awjlogan/emon32/pcb/models/Amphenol12402012E212A.STEP

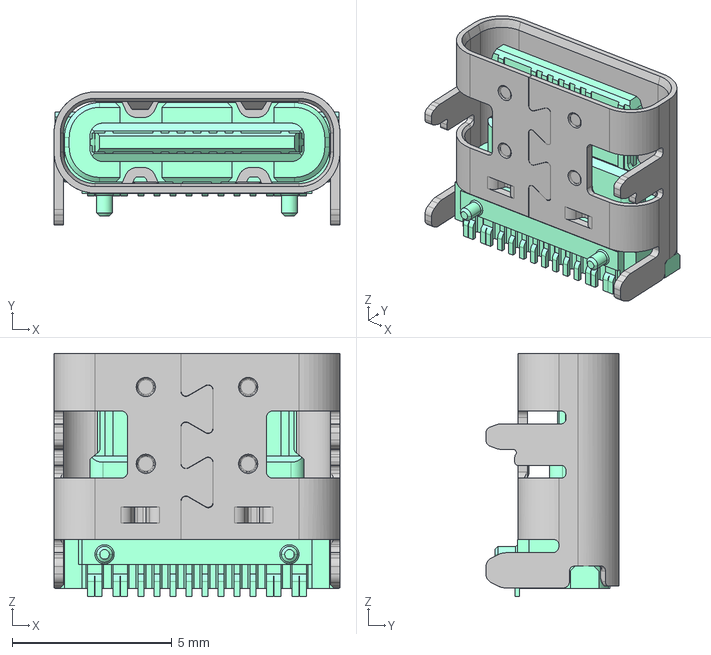
[picture p3: CAD file, 2025-05-18]
pcb/models/Amphenol12402012E212A.STEP
8.94 x 4.16 x 7.60 mm
