awjlogan/emon32/pcb/emonpi3/fascias/export-emonpi3-V1.0/back-emonpi3-V1.0.dxf

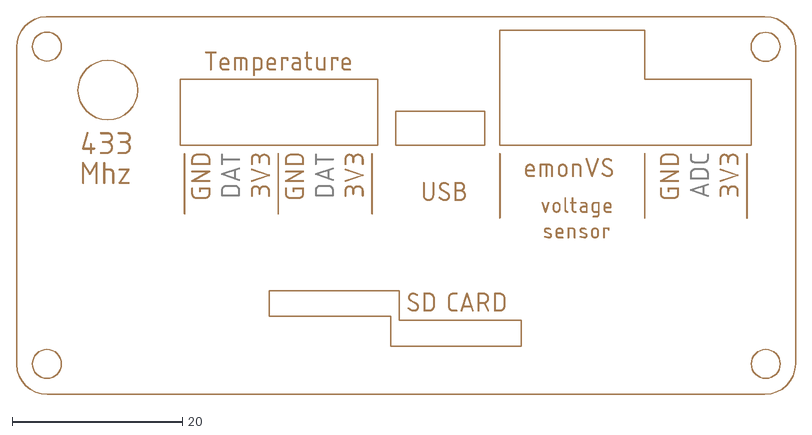
[picture p4: CAD file, 2025-11-04]
pcb/emonpi3/fascias/export-emonpi3-V1.0/back-emonpi3-V1.0.dxf
91.4 x 44.4
