awjlogan/emon32/pcb/models/pxc_5441388_01_00_BCH-350H-6-GN_3D.stp

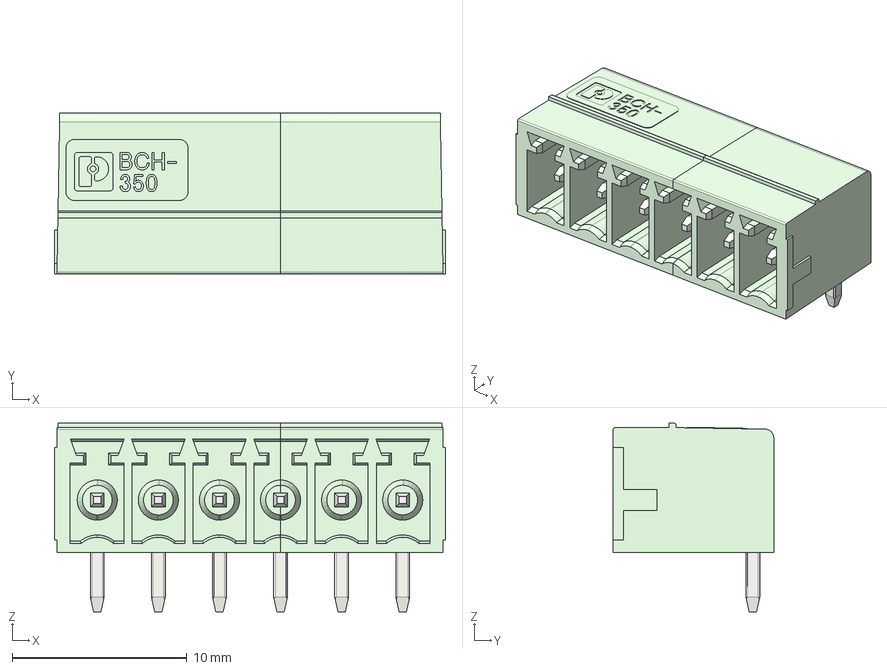
[picture p5: CAD file, 2025-05-18]
pcb/models/pxc_5441388_01_00_BCH-350H-6-GN_3D.stp
22.4 x 9.20 x 10.8 mm
