awjlogan/emon32/pcb/emonpi3/fascias/export-emonpi3-V1.0/top-emonpi3-V1.0.dxf

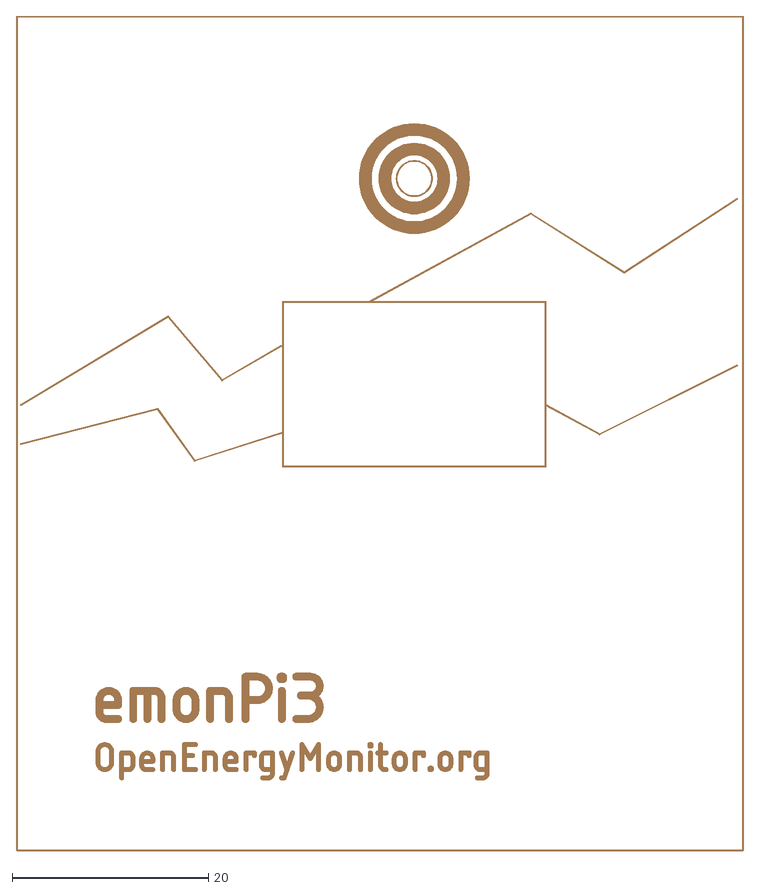
[picture p6: CAD file, 2025-11-04]
pcb/emonpi3/fascias/export-emonpi3-V1.0/top-emonpi3-V1.0.dxf
74.1 x 85.2
