awjlogan/emon32/pcb/models/pxc_5441359_01_00_BCH-350H-3-GN_3D.stp

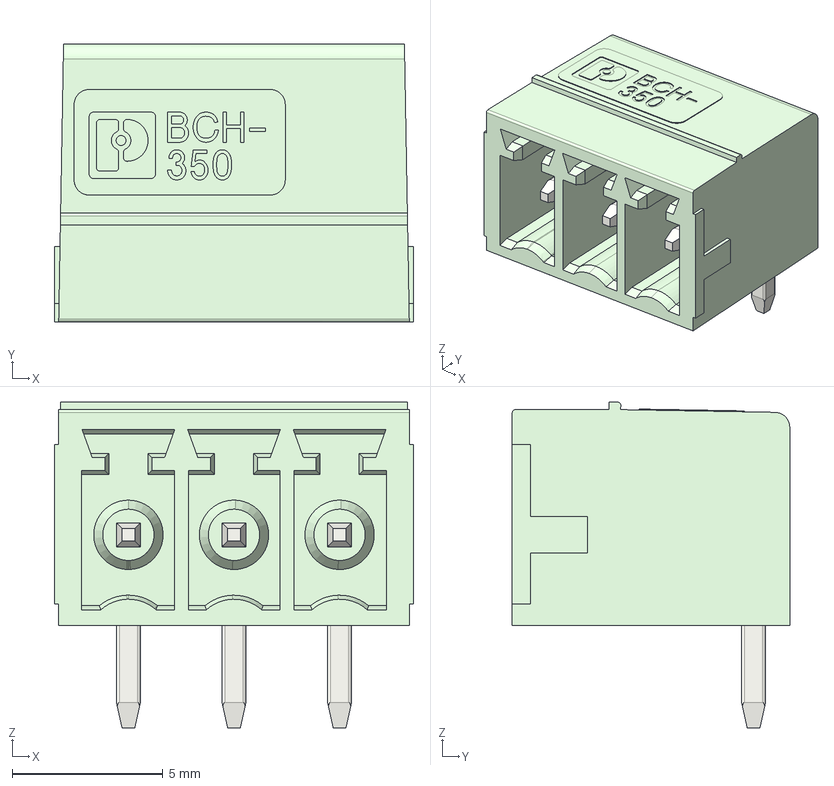
[picture p7: CAD file, 2025-05-18]
pcb/models/pxc_5441359_01_00_BCH-350H-3-GN_3D.stp
11.9 x 9.20 x 10.8 mm
