awjlogan/emon32/pcb/emonpi3/fascias/export-emonpi3-V1.0/frontA-emonpi3-V1.0.dxf

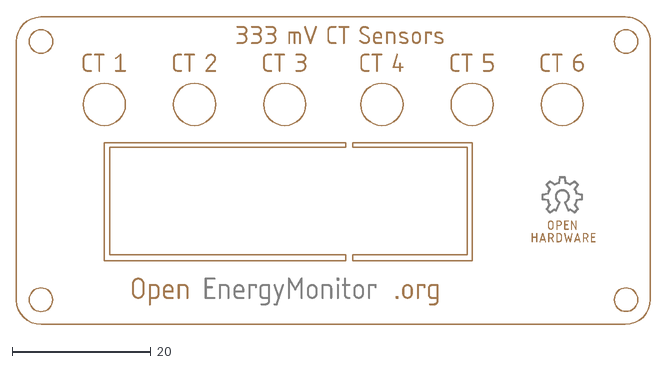
[picture p8: CAD file, 2025-11-04]
pcb/emonpi3/fascias/export-emonpi3-V1.0/frontA-emonpi3-V1.0.dxf
91.5 x 44.4
