awjlogan/emon32/pcb/models/TPS2116DRLR.stp

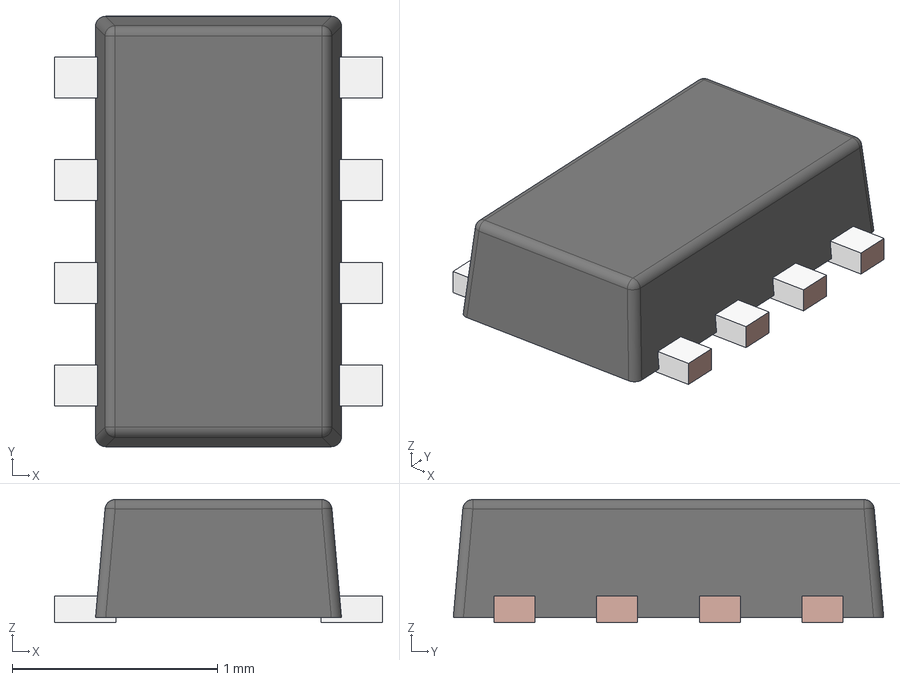
[picture p9: CAD file, 2024-09-29]
pcb/models/TPS2116DRLR.stp
1.60 x 2.10 x 0.6 mm
FRAME-DRL0008A
BODY-SOT
