awjlogan/emon32/pcb/models/LTST-S326KGJRKT.stp

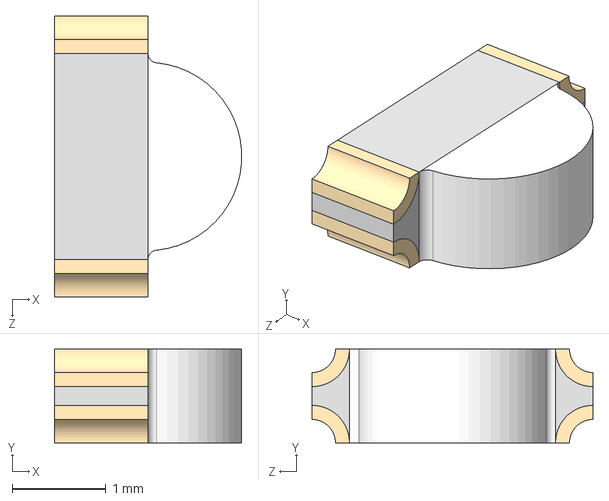
[picture p10: CAD file, 2024-09-29]
pcb/models/LTST-S326KGJRKT.stp
2.00 x 1.00 x 3.00 mm
