awjlogan/emon32/pcb/models/HLE-120-02-F-DV.stp

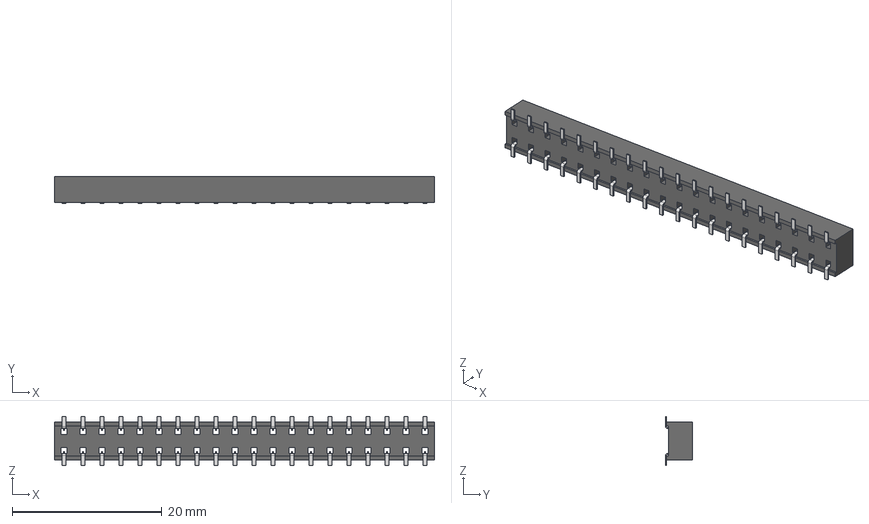
[picture p11: CAD file, 2024-09-29]
pcb/models/HLE-120-02-F-DV.stp
50.8 x 3.66 x 6.58 mm
HLE-120-02-DV_socket
C-132-12-20-F-DV
C-132-12-20-F-DV2
