awjlogan/emon32/pcb/models/CUI_DEVICES_SJ-3523-SMT-TR.step

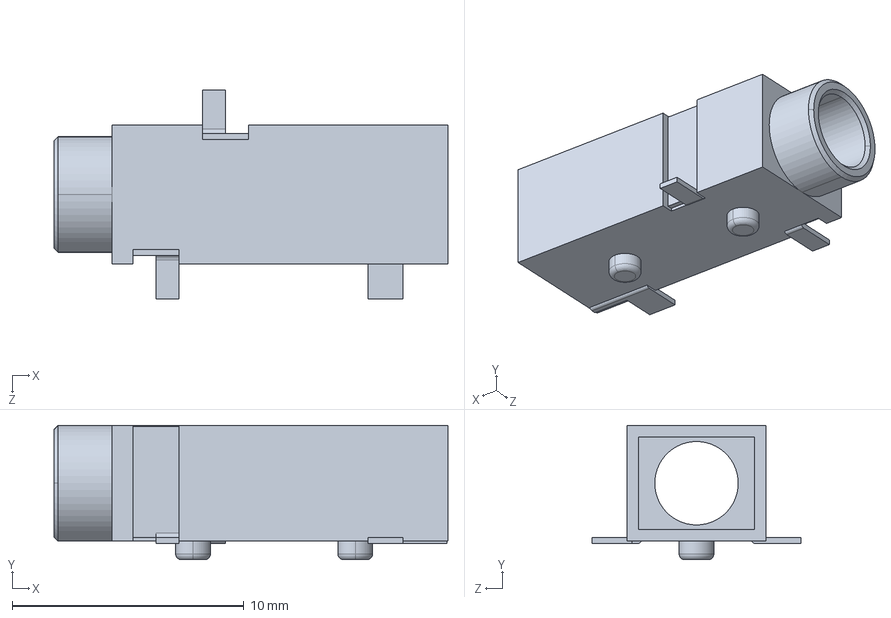
[picture p12: CAD file, 2023-05-02]
pcb/models/CUI_DEVICES_SJ-3523-SMT-TR.step
17.0 x 5.80 x 9.00 mm
