awjlogan/emon32/pcb/models/132136-12.stp

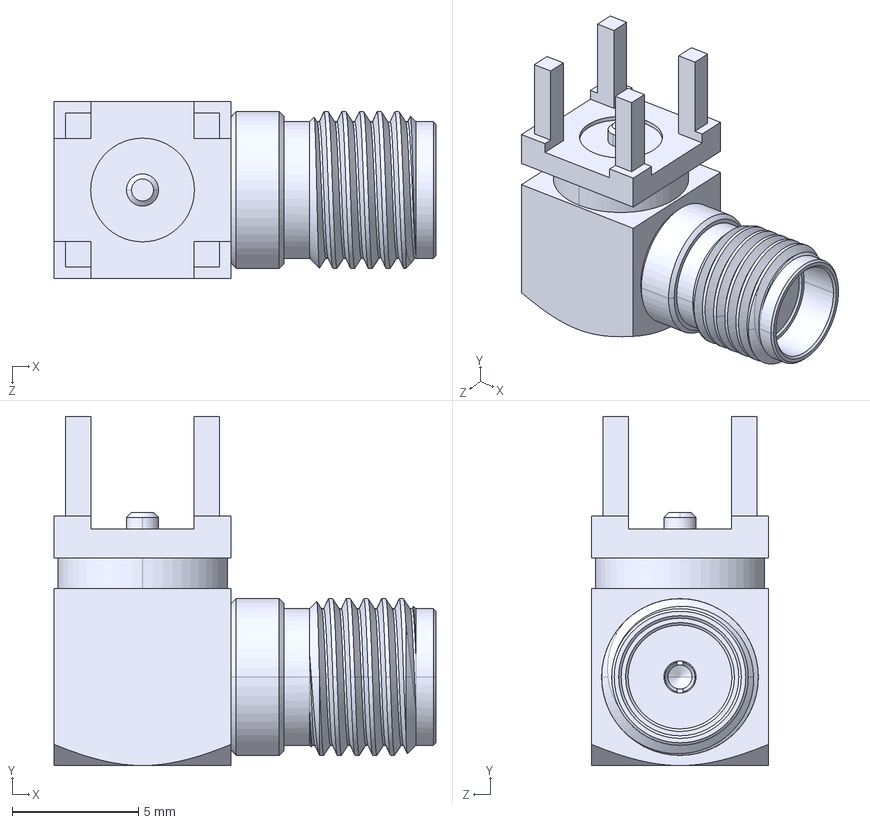
[picture p13: CAD file, 2024-03-06]
pcb/models/132136-12.stp
15.1 x 13.8 x 7.00 mm
