awjlogan/emon32/pcb/models/54601-906WPLFc.stp

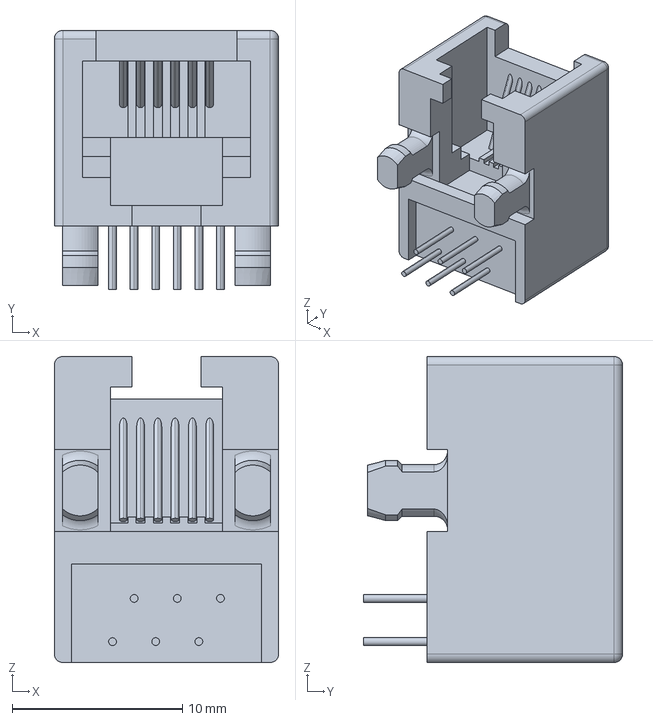
[picture p14: CAD file, 2023-05-02]
pcb/models/54601-906WPLFc.stp
13.2 x 15.2 x 18.0 mm
