awjlogan/emon32/pcb/models/54602-908LFc.stp

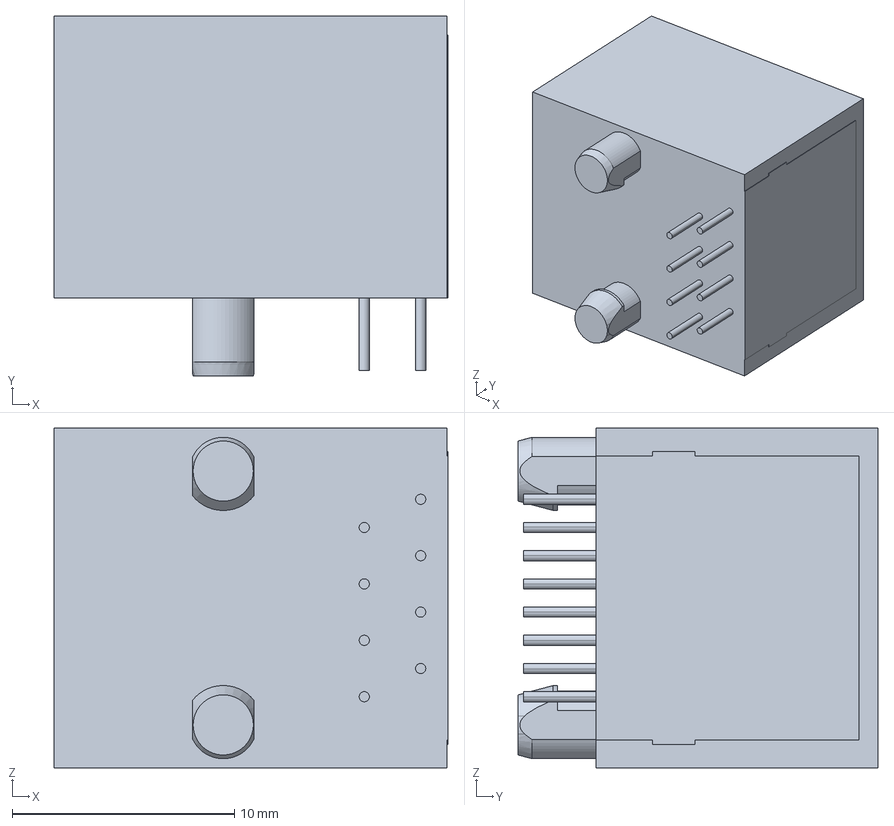
[picture p15: CAD file, 2023-05-02]
pcb/models/54602-908LFc.stp
17.7 x 16.2 x 15.3 mm
