awjlogan/emon32/pcb/emonpi3/emonPi3-schematic.pdf

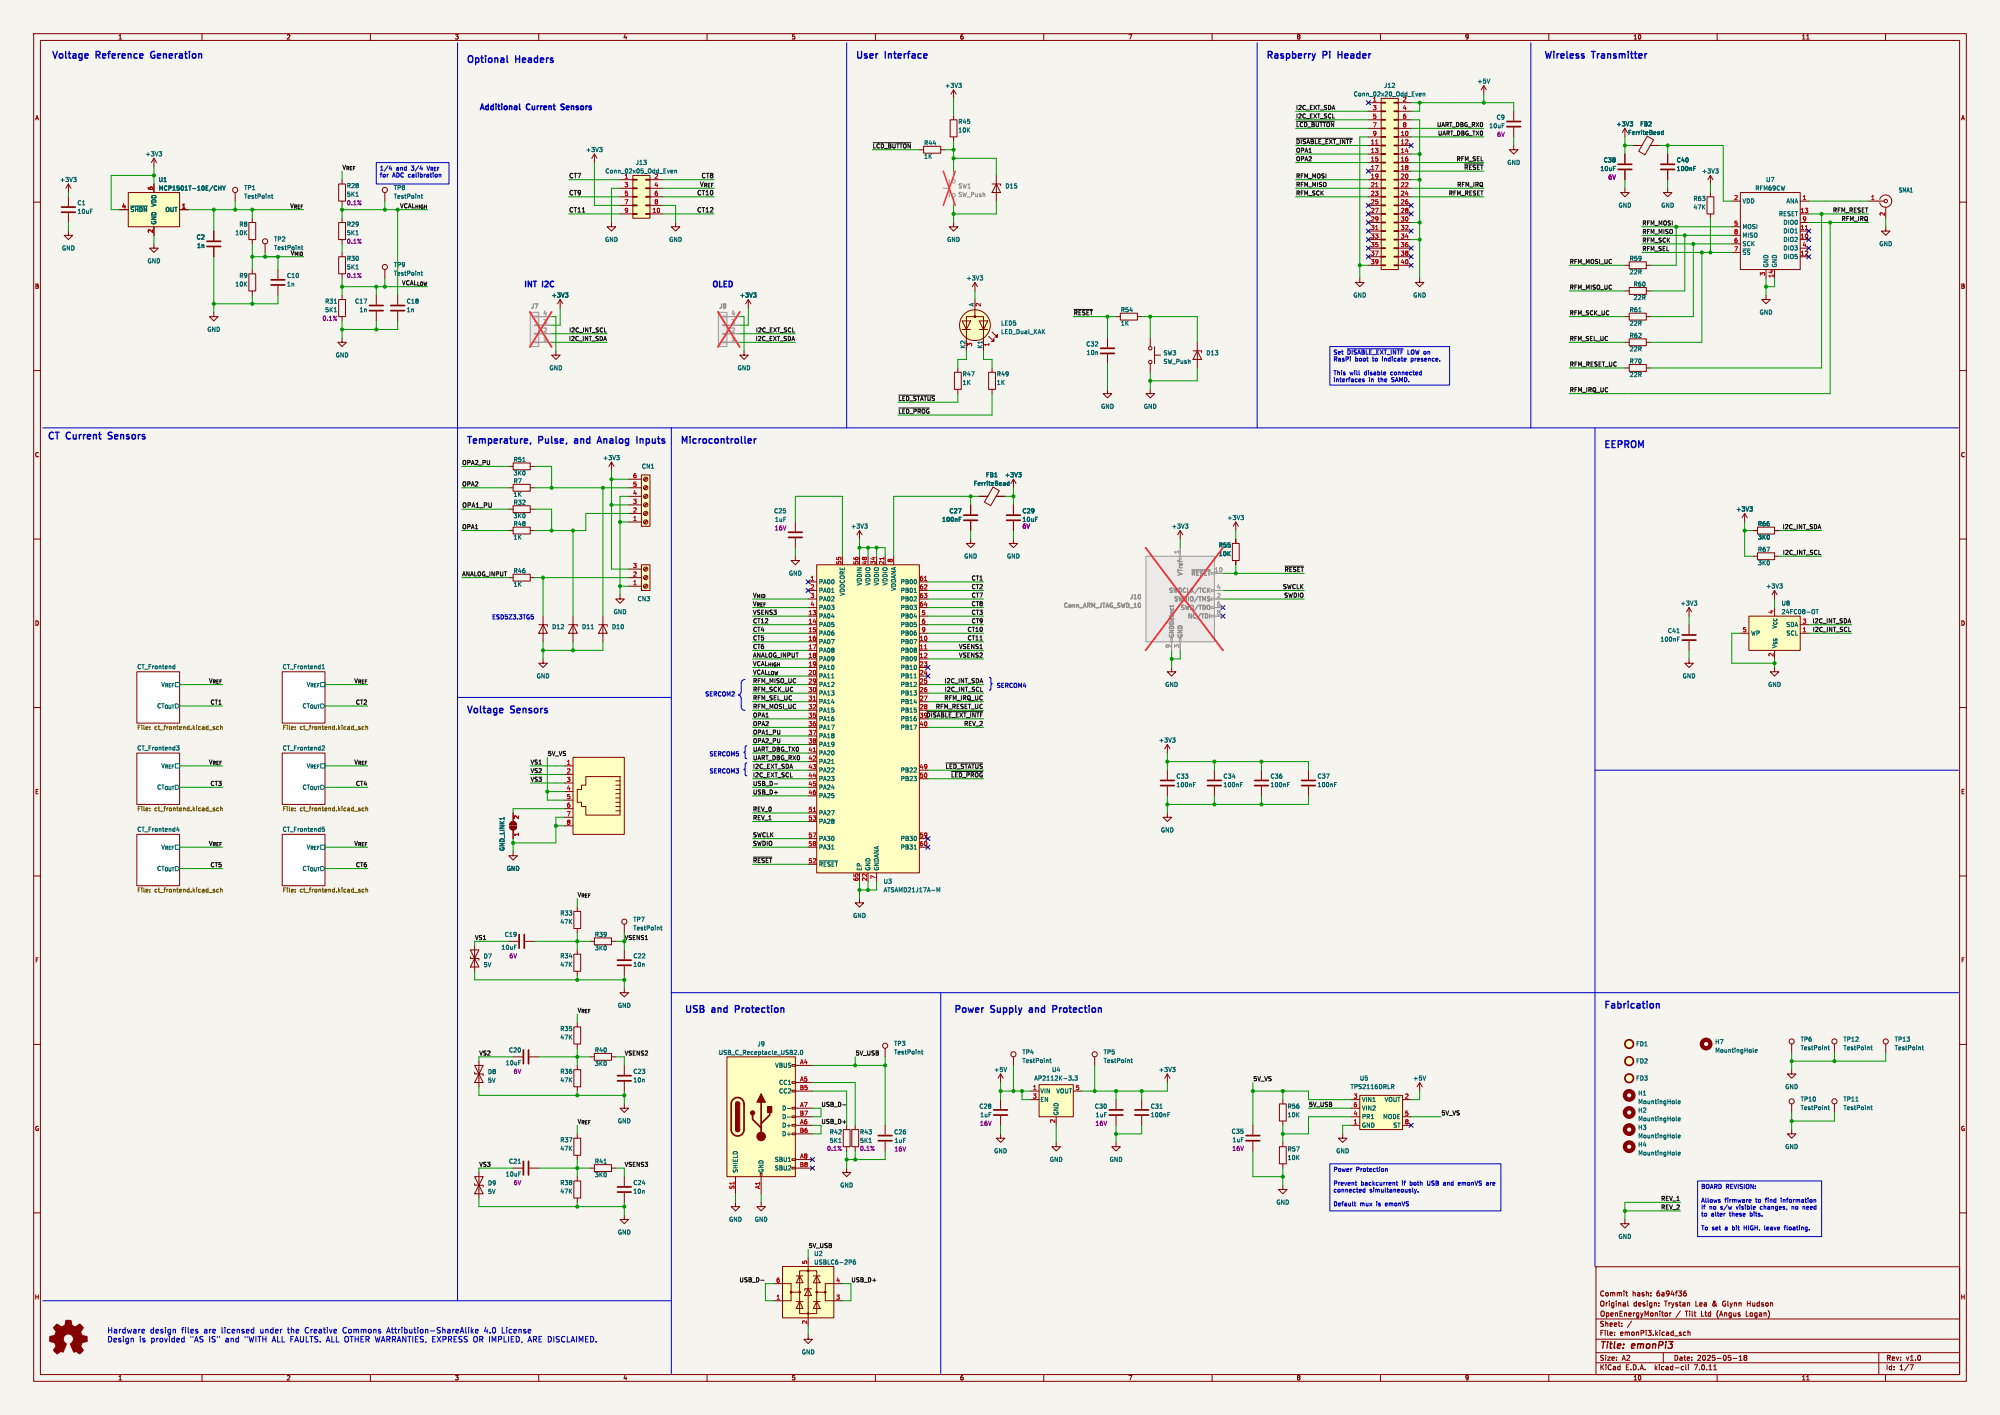
[picture p16: page 1]

2 EN 3 VOUT 5 U4 AP2112K-3.3 H4 MountingHole H2 MountingHole H3 MountingHole R43

If no s/w visible changes, no need
to alter these bits. To set a bit HIGH, leave floating.

Design is provided "AS IS" and "WITH ALL FAULTS. ALL OTHER WARRANTIES, EXPRESS OR IMPLIED, ARE DISCLAIMED.

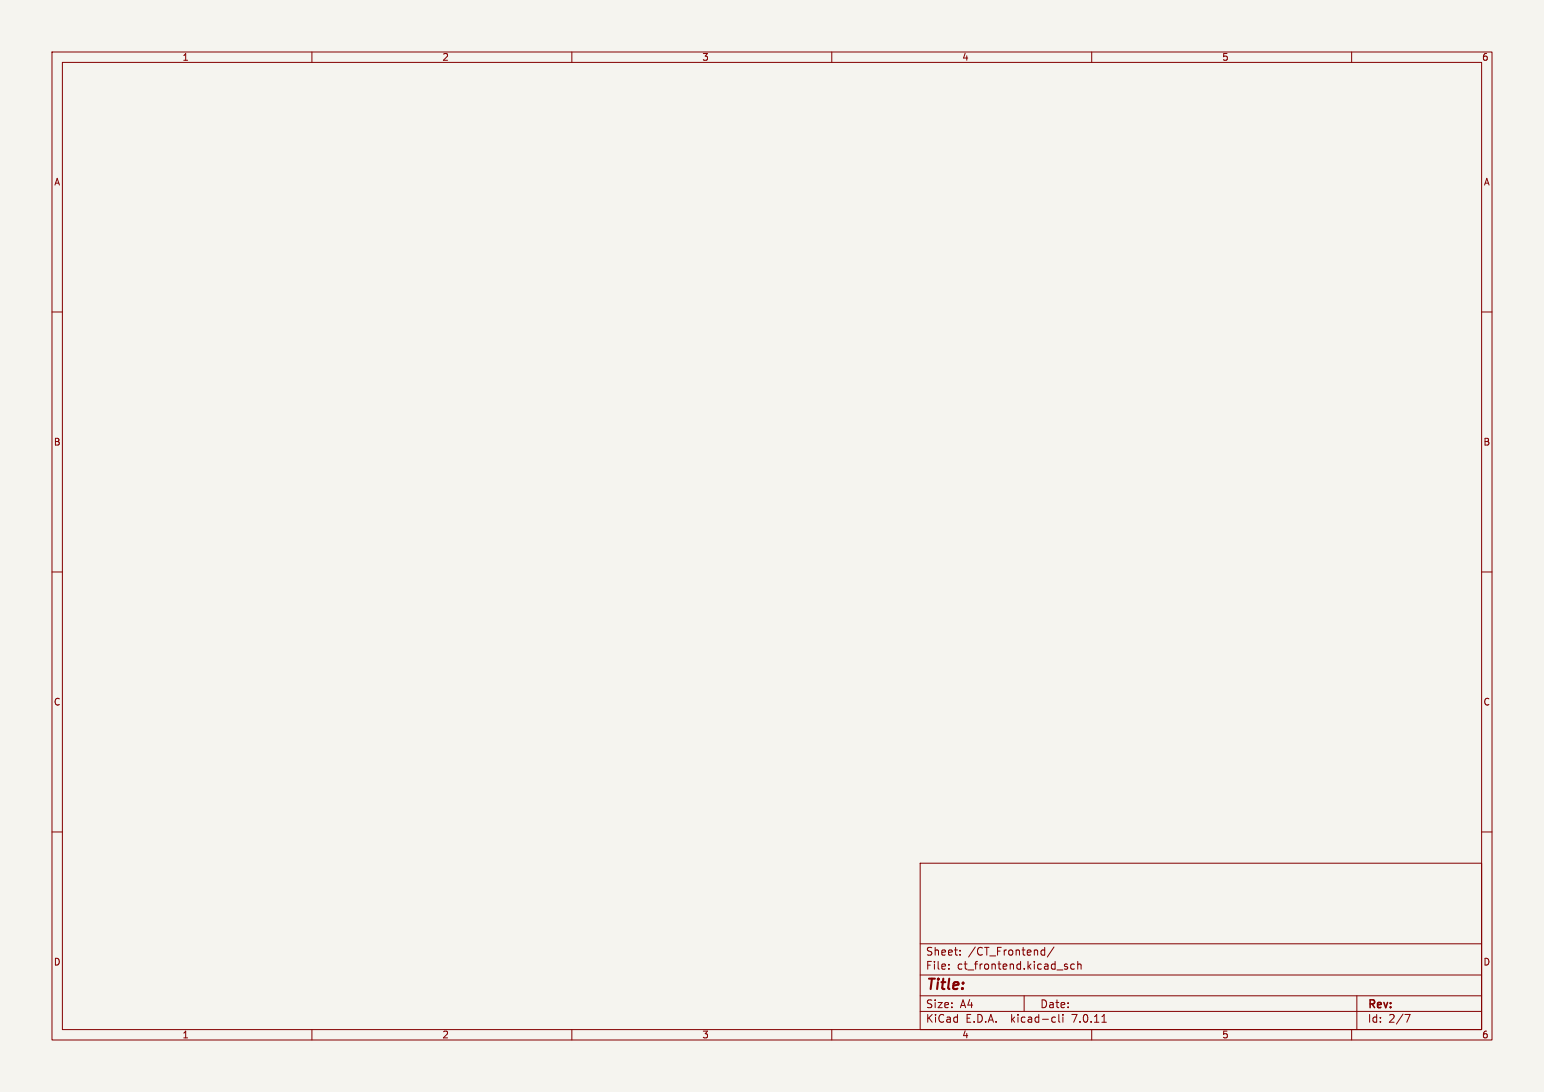
[picture p17: page 2]

Id: 2/7 Title: File: ct_frontend.kicad_sch Sheet: /CT_Frontend/

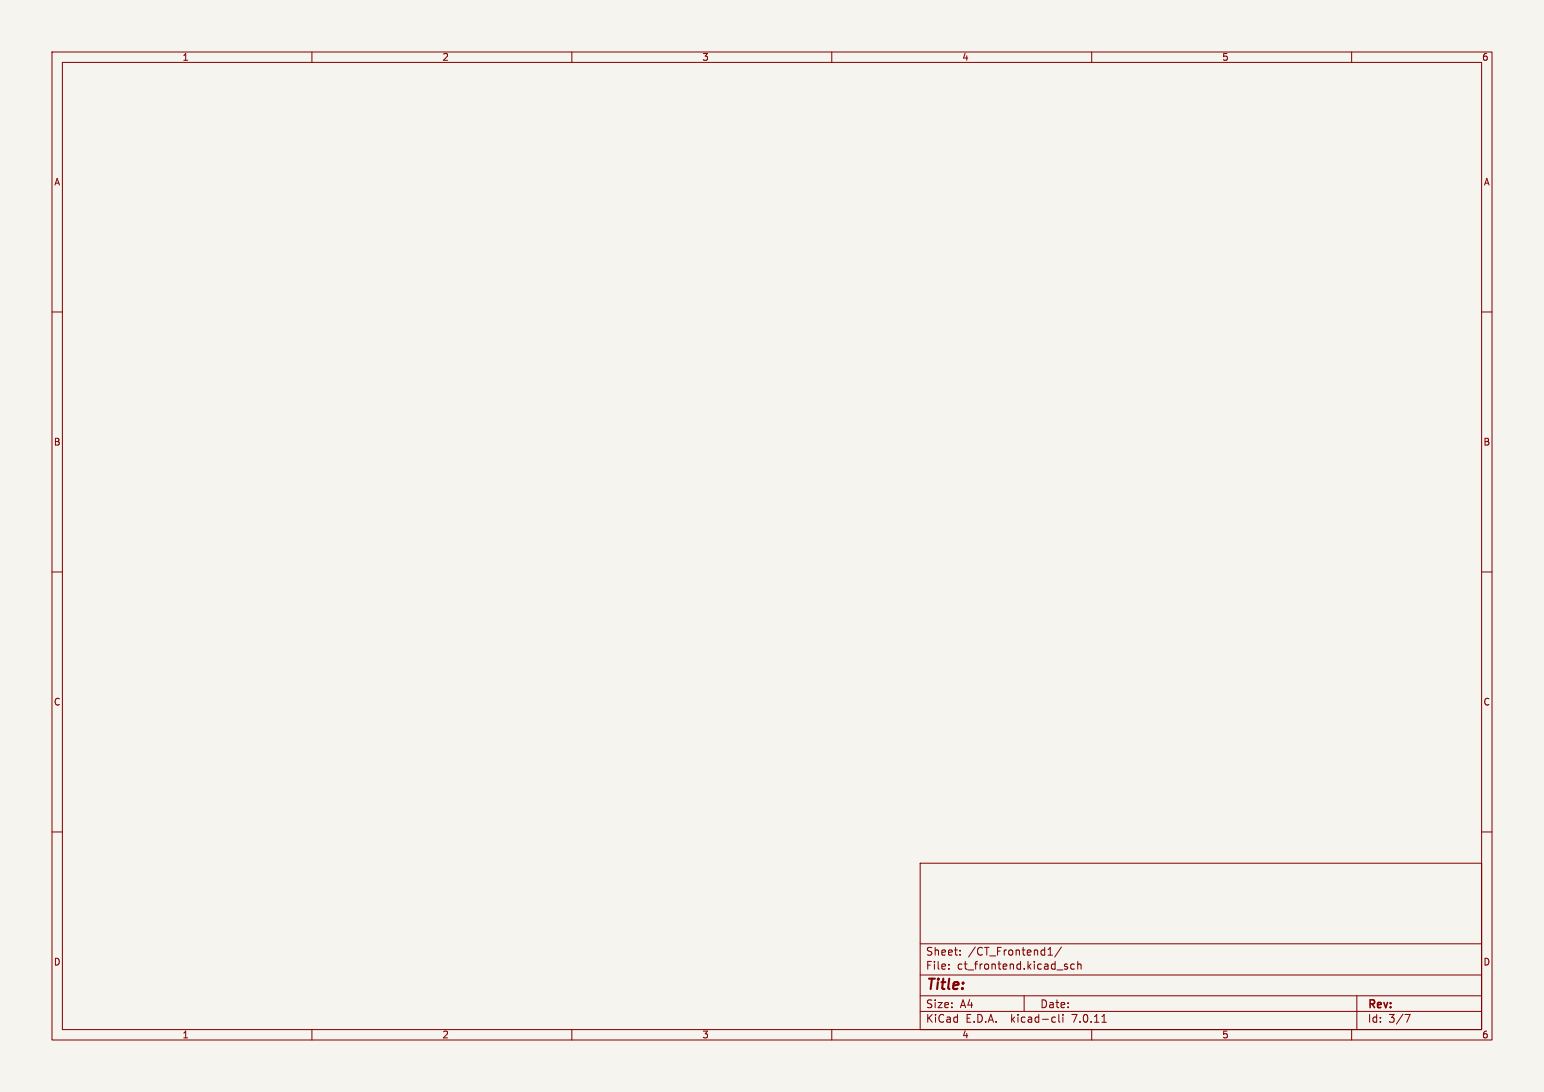
[picture p18: page 3]

Id: 3/7 Title: File: ct_frontend.kicad_sch Sheet: /CT_Frontend1/

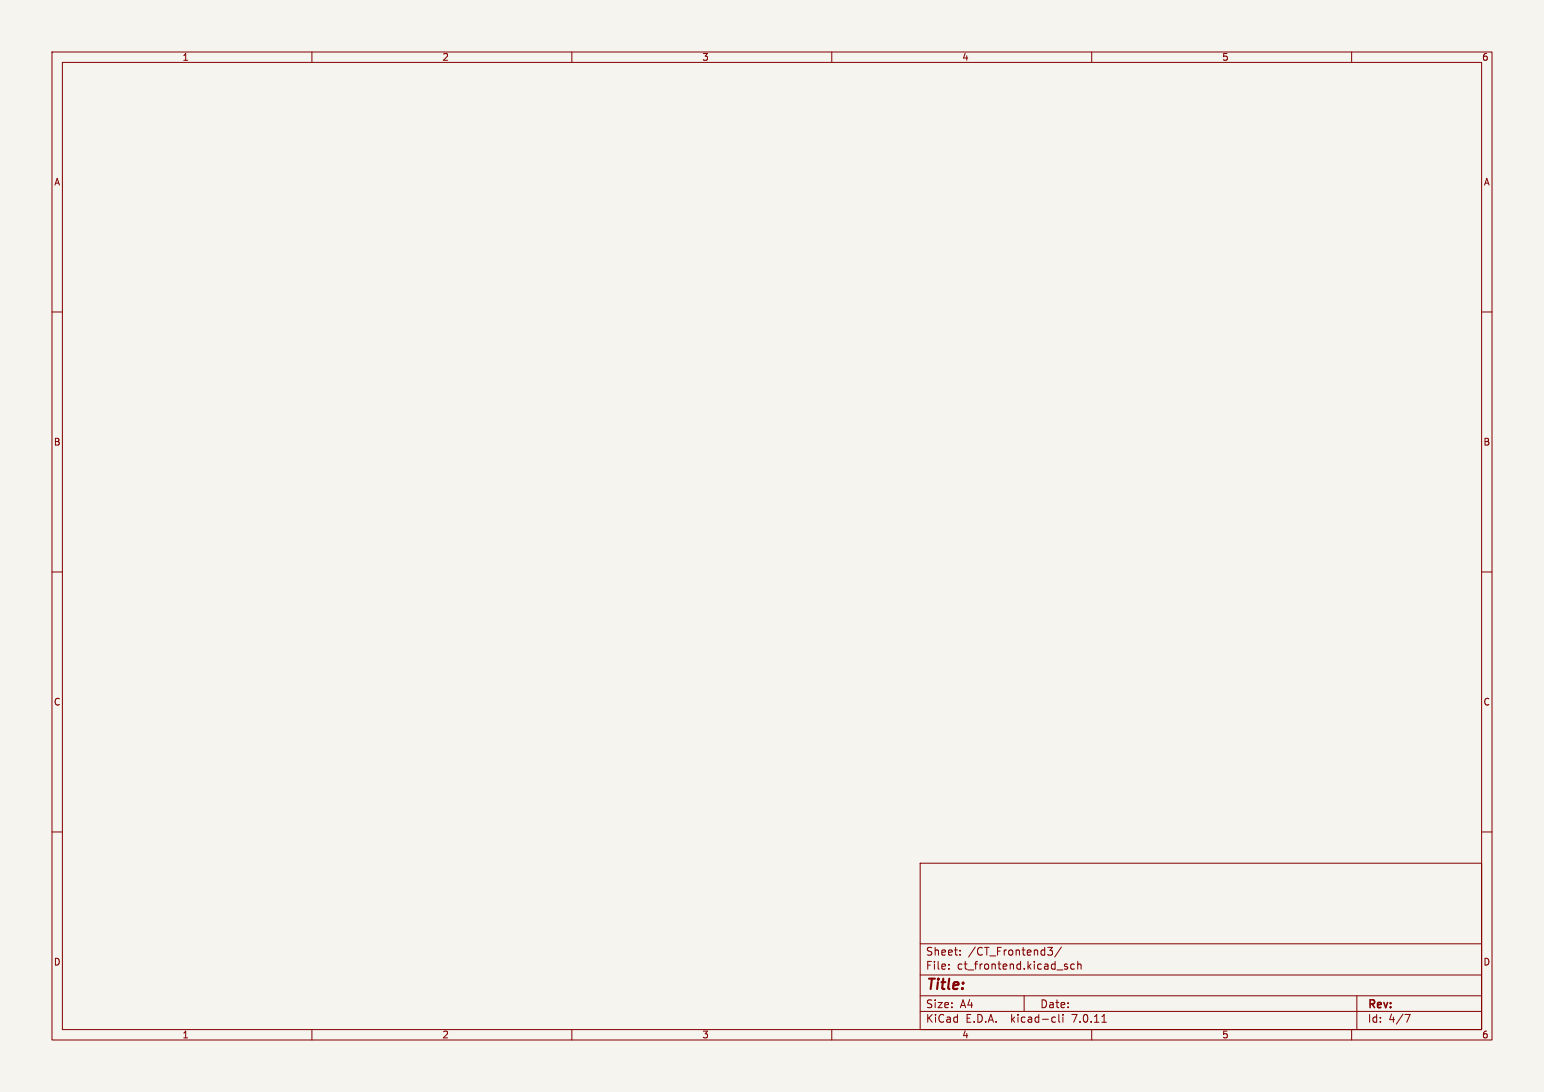
[picture p19: page 4]

Id: 4/7 Title: File: ct_frontend.kicad_sch Sheet: /CT_Frontend3/

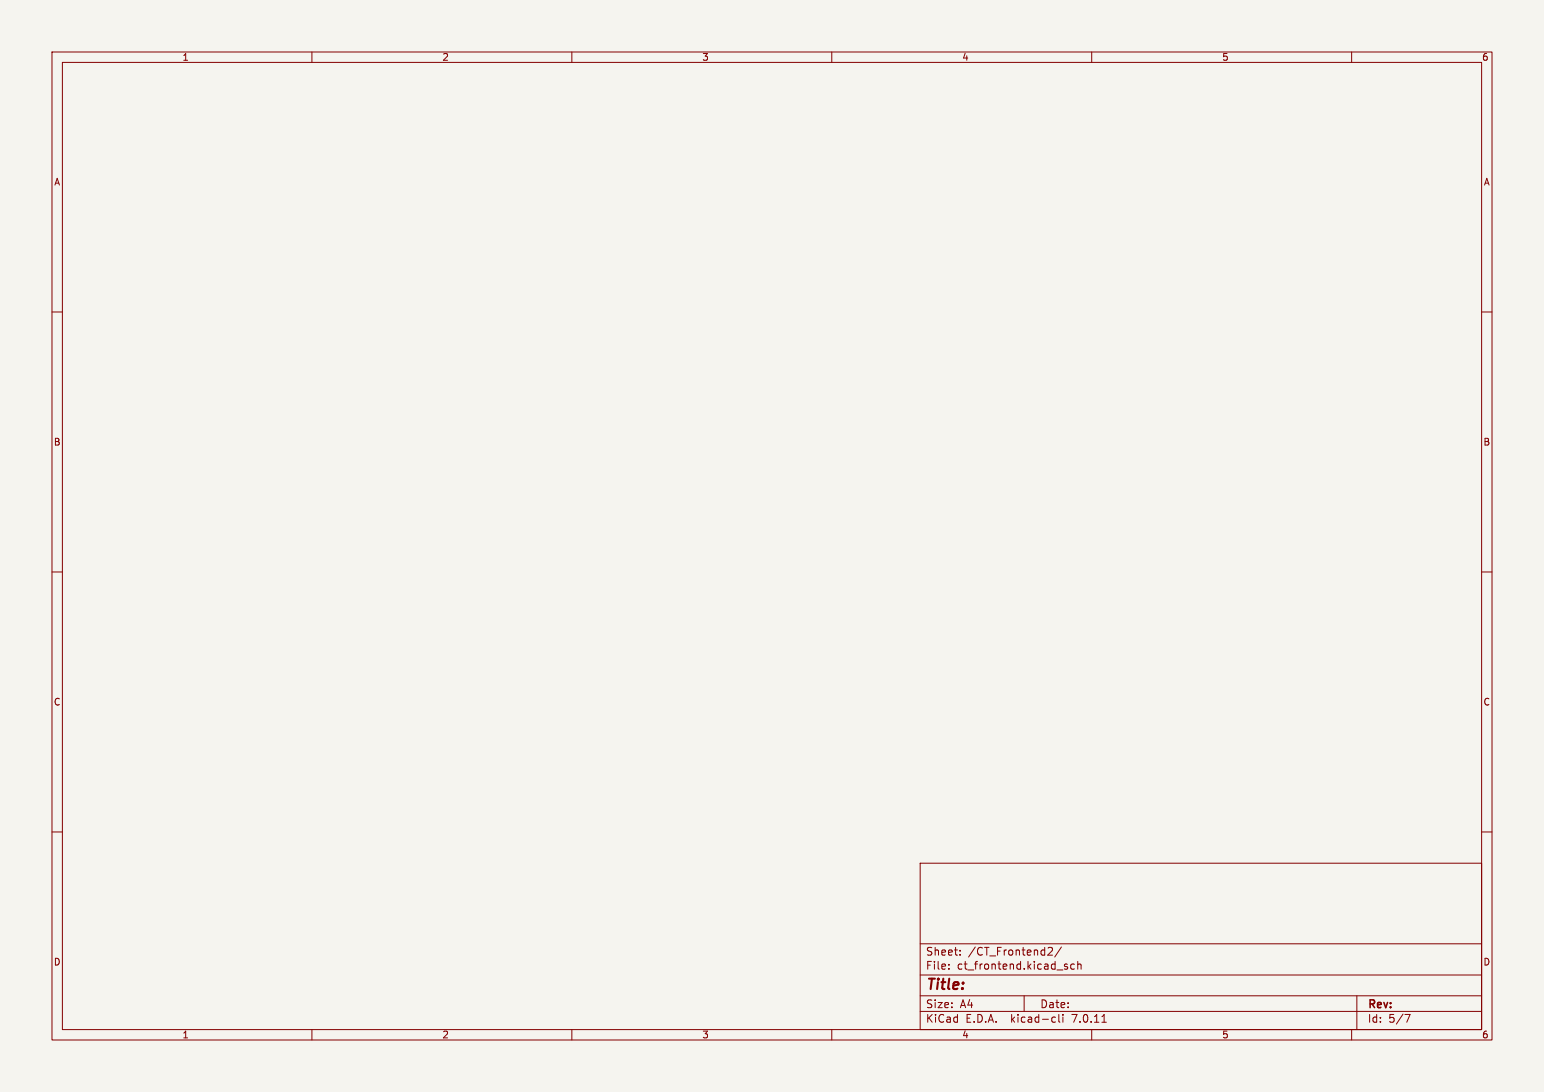
[picture p20: page 5]

Id: 5/7 Title: File: ct_frontend.kicad_sch Sheet: /CT_Frontend2/

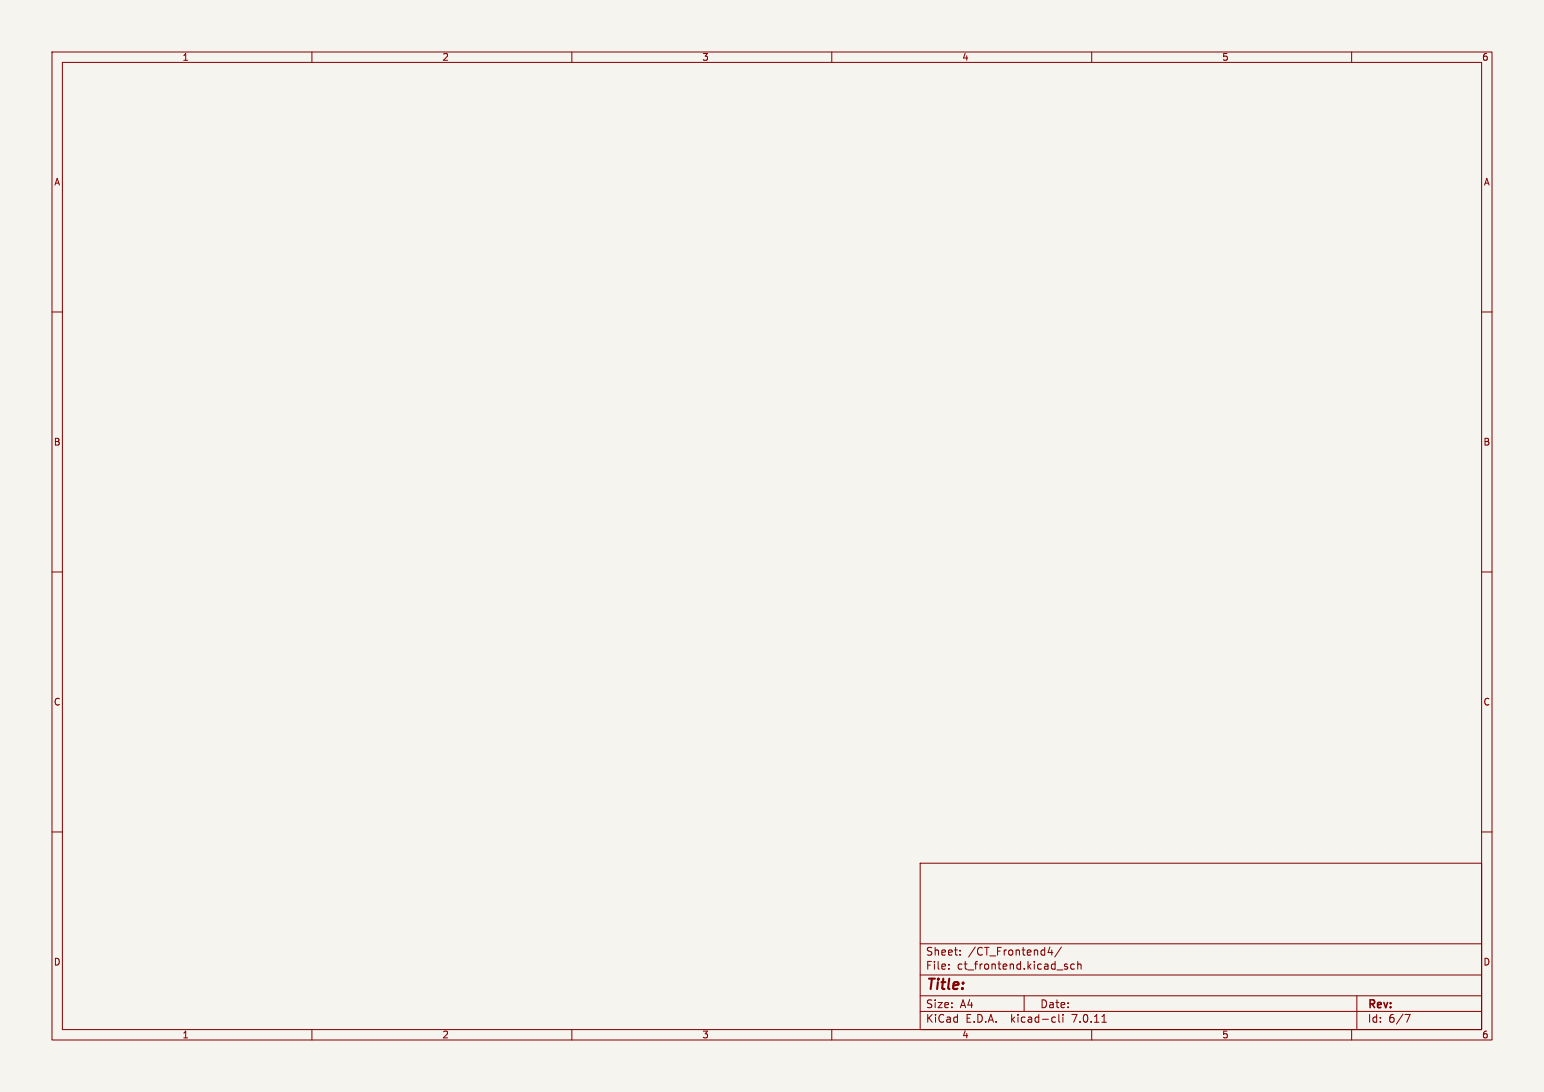
[picture p21: page 6]

Id: 6/7 Title: File: ct_frontend.kicad_sch Sheet: /CT_Frontend4/

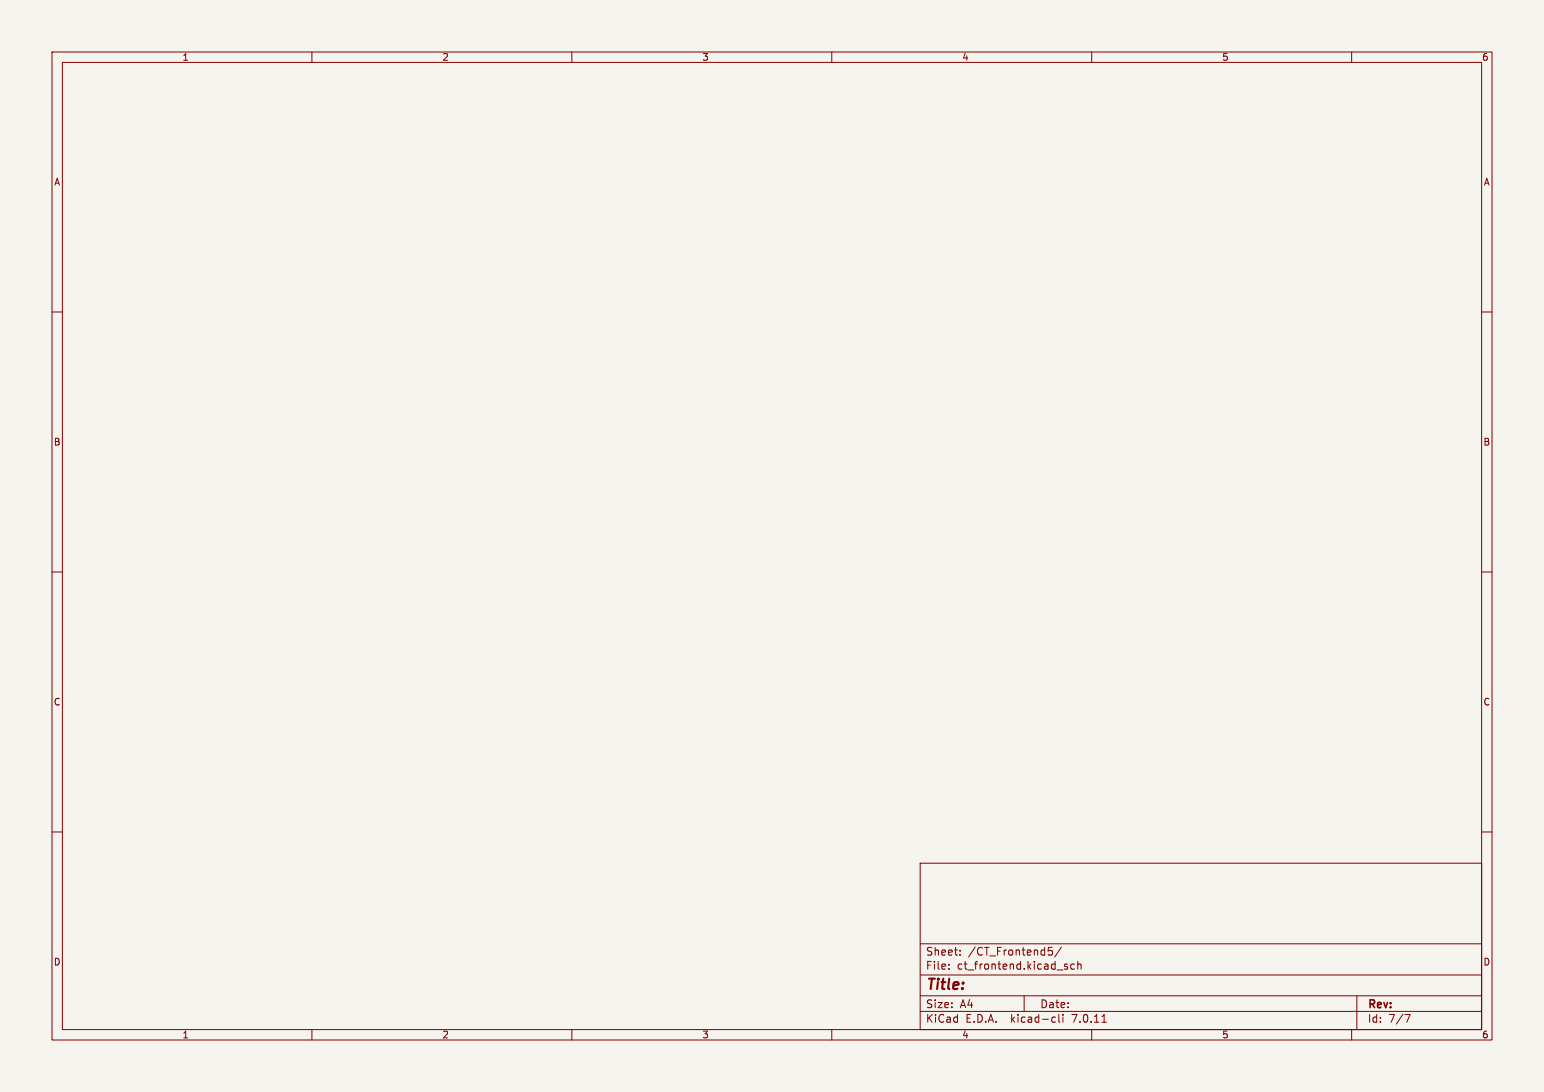
[picture p22: page 7]

Id: 7/7 Title: File: ct_frontend.kicad_sch Sheet: /CT_Frontend5/
