awjlogan/emon32/pcb/emonpi3/emonPi3-floorplan.pdf

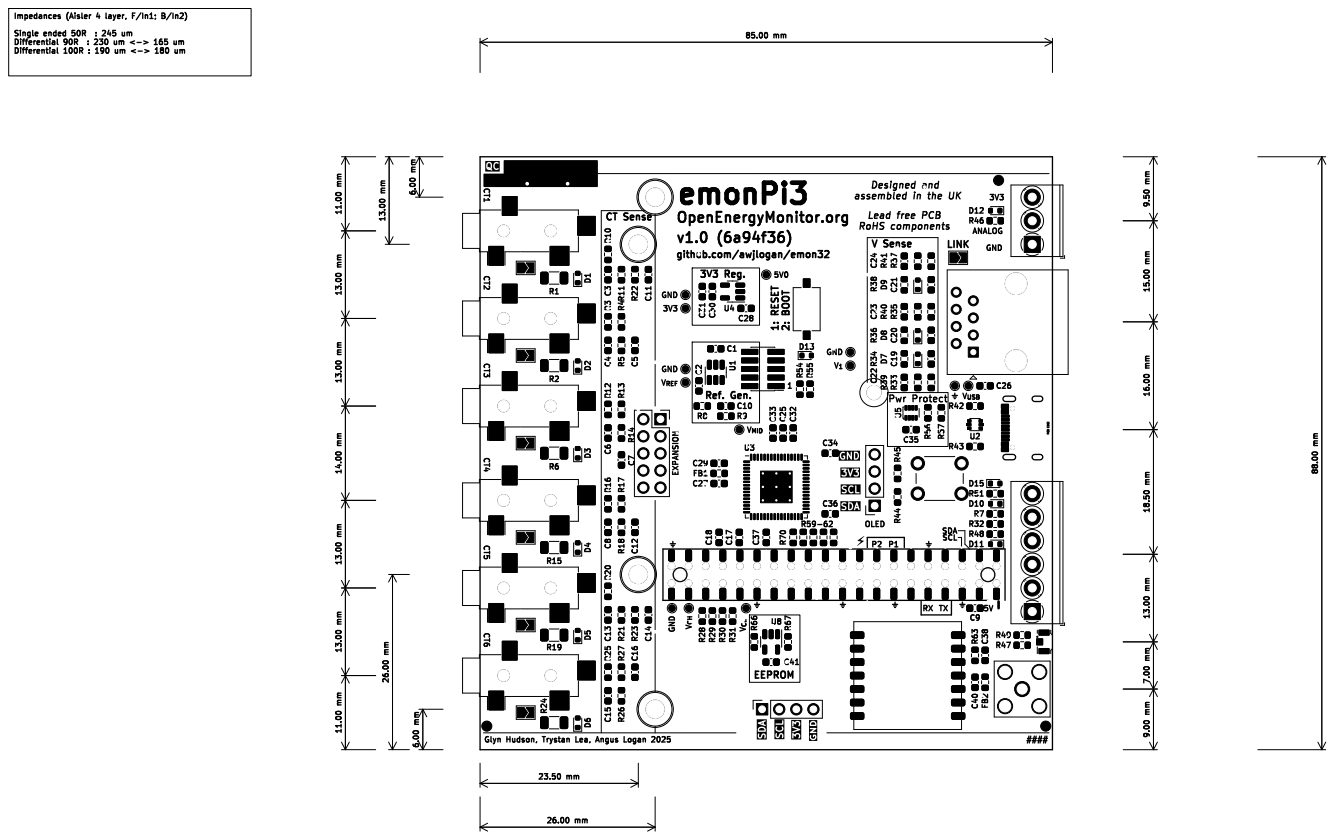
[picture p23: page 1]

þÿ#Ú Designed and
assembled in the UK
V_{USB} GND
