awjlogan/emon32/(commit log)

2023-01-20 * Add EPS PCB to repository
    [emon-pi-sam.kicad_pcb, emon-pi-sam.kicad_sch, emon-pi-sam.sch, raspi.kicad_sch, raspi.sch, sallen-key.kicad_sch, sallen-key.sch, v_ac_ref_gen.kicad_sch]
2023-01-20 * Update 3D model path for KICAD6
    [emon-pi-sam.kicad_pcb]
2023-01-20 * Rename references to emon-pi-sam -> emon32
    [emon-pi-sam.sch, emon32.kicad_pcb, emon32.kicad_sch, raspi.sch, sallen-key.sch, v_ac_ref_gen.sch]
2023-01-20 * Working UART system
2023-01-20 * Timers - SysTick for 1 kHz - TC1 for ADC trigger
2023-01-20 * DMAC
    - Working UART non-blocking function
2023-01-20 * Add DMAC to ADC
    * Trigger ADC by TC event
2023-01-20 * Add UI files
    - Switch and LED, need work still
    * Add sample preprocess wrapper
    - Either discard one sample, todo: implement half band low pass
2023-01-20 * Start replicating emonLibCM functionality
    [emon32.kicad_sch, raspi.kicad_sch, sallen-key.kicad_sch, v_ac_ref_gen.kicad_sch]
2023-01-20 * Event system working for async ADC trigger
2023-01-20 * Add filter designer
2023-01-20 * Further aliasing for UART send if using >1 SERCOM
2023-01-20 * Start configuration menu development - Add get function to UART driver - Add atoi to utilities
2023-01-20 * Half band filter implemented - fixed coefficients/depth - impulse test (no automatic check yet) - filter generator updated
2023-01-20 * Add support for configuration menu - not yet tested in device
    [configuration.h]
2023-01-20 * Start support for external EEPROM on I2C
2023-01-20 * [HELPERS] - Add phase calibration helper script
2023-01-20 * [HAL] - Correct mux for UART RX
2023-01-20 * [PORT] - Add ADC port mux - UART even/odd muxing correct
2023-01-20 * [EEPROM] - Implement interrupt driven async write to I2C EEPROM
2023-01-21 * [TIMER] - Add non-blocking timer
2023-01-21 * [EEPROM]
    - Add low address byte to packet for DMA write
2023-01-24 * [DATA]
    - Use single precision, not double for voltage scaling
2023-01-31 * [UART]
    - Add support for UART for data (use with ESP8266)
2023-02-07 * [PULSE]
    - Add support for single channel pulse counting
    - Remove switch functions, didn't provide any utility
2023-02-13 * [EEPROM]
    - Working read
    - Refactor to remove DMA (for now, at least)
2023-02-14 * [EEPROM]
    - Refactor types and driver
2023-02-16 * [EEPROM]
    - I2C read/write now working
    - Add callback to non-blocking timer
    - Remove event based DMAC transfer for I2C just now
    - Add save routine to configuration
2023-03-13 * [PCB]
    - Add 3D models
    - Plot schematics and PCB
    - Render dev 0.1 with raytracing
    [emon32.kicad_pcb]
2023-05-02 * Fake merge of LC PCB
    [54601-906WPLFc.stp, 54602-908LFc.stp, CUI_DEVICES_SJ-3523-SMT-TR.step, emon32-lc.kicad_pcb, emon32-lc.kicad_sch, frontend.kicad_sch]
2023-05-05 * [PCB LC]
    - Change to MCP1501 reference
    - Some retouching of traces
    [emon32-lc.kicad_pcb, emon32-lc.kicad_sch, frontend.kicad_sch]
2023-05-17 * [PCB LC]
    - Revise USB routing/spacing
    - Remove CT current out burden resistors
    - Add AAF filter, revise ADC input filter values
    [emon32-lc.kicad_pcb, emon32-lc.kicad_sch, frontend.kicad_sch]
2023-05-17 * [PCB LC]
    - Fix opamp bypass
    [emon32-lc.kicad_pcb, emon32-lc.kicad_sch, frontend.kicad_sch]
2023-05-18 * [PCB LC]
    - Final touch up for manufacture
    [emon32-lc.kicad_pcb]
2023-05-18 * [RFM69]
    - Add SPI configuration and functions
    - Add minimal RFM69 implementation
2023-05-18 * [SPI]
    - Refactor the SPI functions
2023-05-20 * [PCB LC]
    - Bump to KiCad 7
    - Recalculate ADC input RC filter
    [emon32-lc.kicad_pcb, emon32-lc.kicad_sch, frontend.kicad_sch]
2023-05-30 * Separate hardware and firmware repos
    [configuration.h]
2023-07-19 * Remove original large board files
    [emon32.kicad_pcb, emon32.kicad_sch, raspi.kicad_sch, sallen-key.kicad_sch, v_ac_ref_gen.kicad_sch]
2023-07-30 * [PCB LC]
    - First iteration of changes from LC-0.1dev -> LC-0.1
    [emon32-lc.kicad_pcb, emon32-lc.kicad_sch, frontend.kicad_sch]
2023-07-31 * Remove old schematics
2023-08-06 * First commit to bring in emonpi2 Eagle project
    [emonPi_v2.0.1.kicad_pcb, emonPi_v2.0.1.kicad_sch]
2023-08-14 * Remove Eagle imports
    [emon32-Pi2.kicad_pcb, emon32-Pi2.kicad_sch, emonPi_v2.0.1.kicad_pcb, emonPi_v2.0.1.kicad_sch]
2023-08-17 * Change absolute paths to relative
    [emon32-lc.kicad_pcb]
2023-08-17 * Freeze to check paths
    [emon32-Pi2.kicad_pcb, emon32-Pi2.kicad_sch]
2023-08-17 * Add 22R SPI resistors * Continue tidying up board
    [emon32-Pi2.kicad_pcb, emon32-Pi2.kicad_sch]
2023-08-24 * [LC]
    - Move ESP header out of RFM footprint to remove short risk
    - Remove all vias inside RFM footprint
    [emon32-lc.kicad_pcb, emon32-lc.kicad_sch]
2023-08-31 * [emonPi2]
    - Most traces routed
    - holes to be placed
    - input voltage protection to be added
    [emon32-Pi2.kicad_pcb, emon32-Pi2.kicad_sch]
2023-09-01 * [emonPi2]
    - Add mounting holes, rearrange traces to compensate
    [emon32-Pi2.kicad_pcb, emon32-Pi2.kicad_sch]
2023-09-04 * [emonPi2]
    - All routing complete
    [emon32-Pi2.kicad_pcb, emon32-Pi2.kicad_sch]
2023-09-07 * [LC]
    - Change to 8P8C header
    [emon32-lc.kicad_pcb, emon32-lc.kicad_sch]
2023-09-07 * [emonPi2]
    - Freeze for manufacture
    [emon32-Pi2.kicad_pcb, emon32-Pi2.kicad_sch]
2023-09-07 * [Paths]
    - Add 3D model paths
    [emon32-Pi2.kicad_pcb, emon32-lc.kicad_pcb]
2023-10-13 * 0.1 changes
    - DFT (extra testpoints, labelling)
    - Rearrange SERCOM instances for routing
    - Extra LEDs
    - Change headers from pins to sockets
    - Move EEPROM for better routing
    [emon32-Pi2.kicad_pcb, emon32-Pi2.kicad_sch]
2023-11-30 * First update of 0.1dev -> 0.1
    - Reassign SERCOMs and move components
    - Add user switch and LEDs
    - Test and programming pads
    - General tidying of routing
    - Tidy up schematic
    [emon32-Pi2.kicad_pcb, emon32-Pi2.kicad_sch]
2023-12-11 * Freeze to move
    [emon32-Pi2.kicad_pcb]
2023-12-15 * Freeze for move
    [emon32-Pi2.kicad_pcb, emon32-Pi2.kicad_sch]
2023-12-17 * Replace tracks with zones for power/reference
    * Add AA filter on analog in
    [emon32-Pi2.kicad_pcb, emon32-Pi2.kicad_sch]
2023-12-18 * Feature freeze for pi2-0.1
    [132136-12.stp, emon32-Pi2.kicad_pcb, emon32-Pi2.kicad_sch]
2023-12-30 * Manufacturing script
    - Add starter, does schematic and PCB export
    - Add gerber output later
2024-01-01 * [License] - change from GPL to CC SA 4.0
    - More appropriate for hardware and matches schematic
2024-01-07 * Add revision information pins
    * Add CHANGELOG file
    [emon32-Pi2.kicad_pcb, emon32-Pi2.kicad_sch]
2024-01-07 * Add gerber output to generate script
2024-02-15 * Add hardware zero crossing detector
    - Comparator with hysteresis referenced to V_MID
    * Add USB presence detection
    - Allow device to switch to USB serial if present
    [emon32-Pi2.kicad_pcb, emon32-Pi2.kicad_sch]
2024-02-16 * Tidy schematic
    * Rename to emonPi3
    * Correct license on schematic (CC-SA 4.0 International)
    [emon32-Pi2.kicad_pcb, emonPi3.kicad_pcb, emonPi3.kicad_sch]
2024-02-25 * Final touch up for manufacture
    - BoM generation as part of script
    - Tidy up README
    - Correct part reference for ATSAMD21J17 in schematic
    [emonPi3.kicad_sch]
2024-03-05 * Replace RPi header with SMD
    * Replace Cortex-M 10pin with SMD
    [emonPi3.kicad_pcb, emonPi3.kicad_sch]
2024-03-05 * Fix missing ground connection
    [emonPi3.kicad_pcb]
2024-03-17 * Add through SMD 26 pin header model
    [HLE-113-02-F-DV-BE-A.stp, emonPi3.kicad_pcb]
2024-03-19 * Software select of OneWire or pulse input
    - https://community.openenergymonitor.org/t/whats-happened-to-emontx-v4/25775/22
    - Add pull up resistors on GPIO pins, rather than hard wiring
    - Move revision pin REV_0 to pin 1
    [emonPi3.kicad_pcb, emonPi3.kicad_sch]
2024-03-20 * Connect RFM module reset and IRQ
    - https://community.openenergymonitor.org/t/whats-happened-to-emontx-v4/25775/28
    - Connect microcontroller to reset and IRQ from RFM
    - Reroute USB sense
    [emonPi3.kicad_pcb, emonPi3.kicad_sch]
2024-03-21 * Add jumpers to connect CT burden resistors
    - Allows use of current output CTs which may already be in use
    - "Refactor" the common CT frontend into a separate hierarchy
    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
    [ct_frontend.kicad_sch, emonPi3.kicad_pcb, emonPi3.kicad_sch]
2024-03-23 * Add mounting hole for OLED
    - For https://www.aliexpress.com/item/32957309383.html
    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
    [emonPi3.kicad_pcb, emonPi3.kicad_sch]
2024-03-24 * Add mounting hole for external WiFi board
    - 2.5 mm diameter for (future) WiFi extender
    - Move RST and IRQ from RFM, label 26pin header
    [emonPi3.kicad_pcb, emonPi3.kicad_sch]
2024-04-06 * Swap SPI MOSI and !SS pins, incorrect in v0.1
    [emonPi3.kicad_pcb, emonPi3.kicad_sch]
2024-04-06 * Tidy up placement
    [emonPi3.kicad_pcb]
2024-04-10 * Move external interface disable pin. Remove USB sense.
    [emonPi3.kicad_pcb, emonPi3.kicad_sch]
2024-05-03 * Swap UART RX and TX labels for consistency
    [emonPi3.kicad_pcb]
2024-05-03 * Change comparator from LMV331 to MCP6546
    [emonPi3.kicad_pcb, emonPi3.kicad_sch]
2024-05-04 * Add power indicator LED to front panel
    [LTST-S326KGJRKT.stp, emonPi3.kicad_pcb, emonPi3.kicad_sch]
2024-05-07 * LED Rationalisation
    - Combine PROG and STATUS as bicolour LED on front panel
    - Mark USER LEDs and switch as DNP, unlikely to be available in
    OEM products.
    [emonPi3.kicad_pcb, emonPi3.kicad_sch]
2024-05-07 * Expose !RESET to Pi to allow entry to bootloader
    [emonPi3.kicad_pcb, emonPi3.kicad_sch]
2024-05-22 * Remove ANALOG_INPUT AA filter
    - Will be onboard expander board
    - Allows different use of the ANALOG_INPUT port
    [emonPi3.kicad_pcb, emonPi3.kicad_sch]
2024-06-02 * Split ANALOG_INPUT and CT12
    - Allows all 12 CTs to be used along with the ANALOG_INPUT
    - Removed USER LED0
    [emonPi3.kicad_pcb, emonPi3.kicad_sch]
2024-06-09 * [ESD] Revise ESD protection strategy
    - All inputs and buttons have TVS and injection current limit
    [ct_frontend.kicad_sch, emonPi3.kicad_pcb, emonPi3.kicad_sch]
2024-06-09 * Add missing trace
    [emonPi3.kicad_pcb, emonPi3.kicad_sch]
2024-06-27 * wip
    [emonPi3.kicad_sch]
2024-07-10 * DFM: Move RPi connector to top side
    - All SMD components now top side, save process step
    [emonPi3.kicad_pcb, emonPi3.kicad_sch]
2024-07-21 Mark zero crossing as DNP
    [emonPi3.kicad_pcb, emonPi3.kicad_sch]
2024-07-22 * Add runtime pull up to second OPA line
    [emonPi3.kicad_pcb, emonPi3.kicad_sch]
2024-07-28 * Silkscreen tidy
    [emonPi3.kicad_pcb, emonPi3.kicad_sch]
2024-08-13 * Change reset switch to SMD
    - Won't be used much as bootloader can be accessed
    through software. Mainly for development.
    [emonPi3.kicad_pcb, emonPi3.kicad_sch]
2024-09-09 * [Header] Use 40 pin RasPi header and move 6CT header
    - Use a 40 pin header for RasPi
    - Move 6CT (and change pinout) to allow this
    - Use routing mapping for CT inputs, do remap in software
    [emonPi3.kicad_pcb, emonPi3.kicad_sch]
2024-09-15 * [Header] Add 40 pin RPi header 3D model
    [HLE-120-02-F-DV.stp, emonPi3.kicad_pcb]
2024-09-26 * Changes for manufacture
    - Better silkscreen naming
    - Move test points to top layer and remove alignment holes
    - Remove additional UART pads
    [emonPi3.kicad_pcb, emonPi3.kicad_sch]
2024-09-27 * More refinement
    - Add TPS2116 model
    - Remove ground slivers
    - 50R trace for RFM output
    [TPS2116DRLR.stp, emonPi3.kicad_pcb, emonPi3.kicad_sch]
2024-09-29 * [v0.2] Final touches for manufacture
    - Remove h/w zero crossing
    - Adjust hole spacing for CT expander
    - Add teardrops
    [ct_frontend.kicad_sch, emonPi3.kicad_sch]
2024-09-29 * [6ct] Add initial 6CT expander layout
    [6ct-expander.kicad_pcb, 6ct-expander.kicad_sch, ct_frontend.kicad_sch]
2024-10-30 * [v1.0] First v0.2 -> v1.0 revisions
    [Amphenol12402012E212A.STEP, HLE-113-02-F-DV-BE-A.stp, emonPi3.kicad_sch, pxc_5441359_01_00_BCH-350H-3-GN_3D.stp, pxc_5441388_01_00_BCH-350H-6-GN_3D.stp]
2024-11-10 * Correct footprint for bicolour LED
    - KiCAD library footprint is incorrect.
    [emonPi3.kicad_sch]
2024-11-27 Add commit hook and generate schematics
2025-01-02 * Add additional user measurements and documentation
    [ct_frontend.kicad_sch, emonPi3.kicad_sch]
2025-05-18 Freeze for v1.0
    [ct_frontend.kicad_sch, emonPi3.kicad_sch]
2025-10-16 [6CT] Finalise CT expander board
    [6ct-expander.kicad_pcb, 6ct-expander.kicad_sch, ct_frontend.kicad_sch]
2025-10-28 Freeze for manufacture
    [6ct-expander.kicad_pcb, ct_frontend.kicad_sch]
2025-11-03 Alternate jack for manufacture
    [6ct-expander.kicad_pcb, ct_frontend.kicad_sch]
2025-11-04 * [emonPi3] Add fascias for v1.0
    [back-emonpi3-V1.0.brd, back-emonpi3-V1.0.dxf, bottom-emonpi3-V1.0.brd, frontA-emonpi3-V1.0.brd, frontA-emonpi3-V1.0.dxf, frontA_12CT.brd, frontB-emonpi3-V1.0.brd, top-emonpi3-V1.0.brd]
2025-11-05 Remove LC PCB and references
    [emon32-lc.kicad_pcb, emon32-lc.kicad_sch, frontend.kicad_sch]
2026-05-06 [6CT] Correct header, add extra GND pads
2026-07-20 [CT Expander] Add missing trace on CT12
    - Added missing connection from CT12 to bias network.
