awjlogan/emon32/(notices)

Notices in the files:
pcb/emonpi2/emon32-Pi2.kicad_sch:
Hardware design files are licensed under the Creative Commons Attribution-ShareAlike 3.0 Unported License
pcb/models/HLE-120-02-F-DV.stp:
author */ ('License CC BY-ND 4.0'),
